cjk09083/Tap-Inspection/README.md

# Tap-Inspection

<div>

</a>
</a>

<a href="https://ieeexplore.ieee.org/document/9268255" target="_blank">

</a>
</div>

## 나사선 검사기

## 목적
- 나사선의 불량 여부를 자동으로 판별하고 이를 어플리케이션과 연동하는 검사기 개발

## 담당 
- 안드로이드 어플리케이션
- 아두이노와 PLC, 모터 제어 (SPI, Serial, PWM)
- 앱 <-> 아두이노 통신 (Bluetooth)

## 기능

### 1. 나사선의 불량 여부 판별
 - 모터끝에 나사를 달아 나사선에 삽입/회전시키고 일정량 이상의 역토크가 발생시 에러감지 
<div align="center">

</div></br>

### 2. 어플리케이션 연동
 - 검사 변수를 설정 및 동작 제어하고 검사 결과를 모니터링
<div align="center">
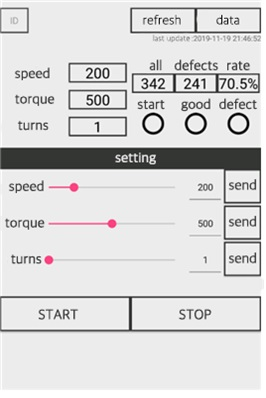
[picture p1: 사진 및 영상/어플리케이션 화면.jpg]

</div></br>
